AnMi3/buryak-pi-2020/docs/rev3/CPU_Shematic.pdf

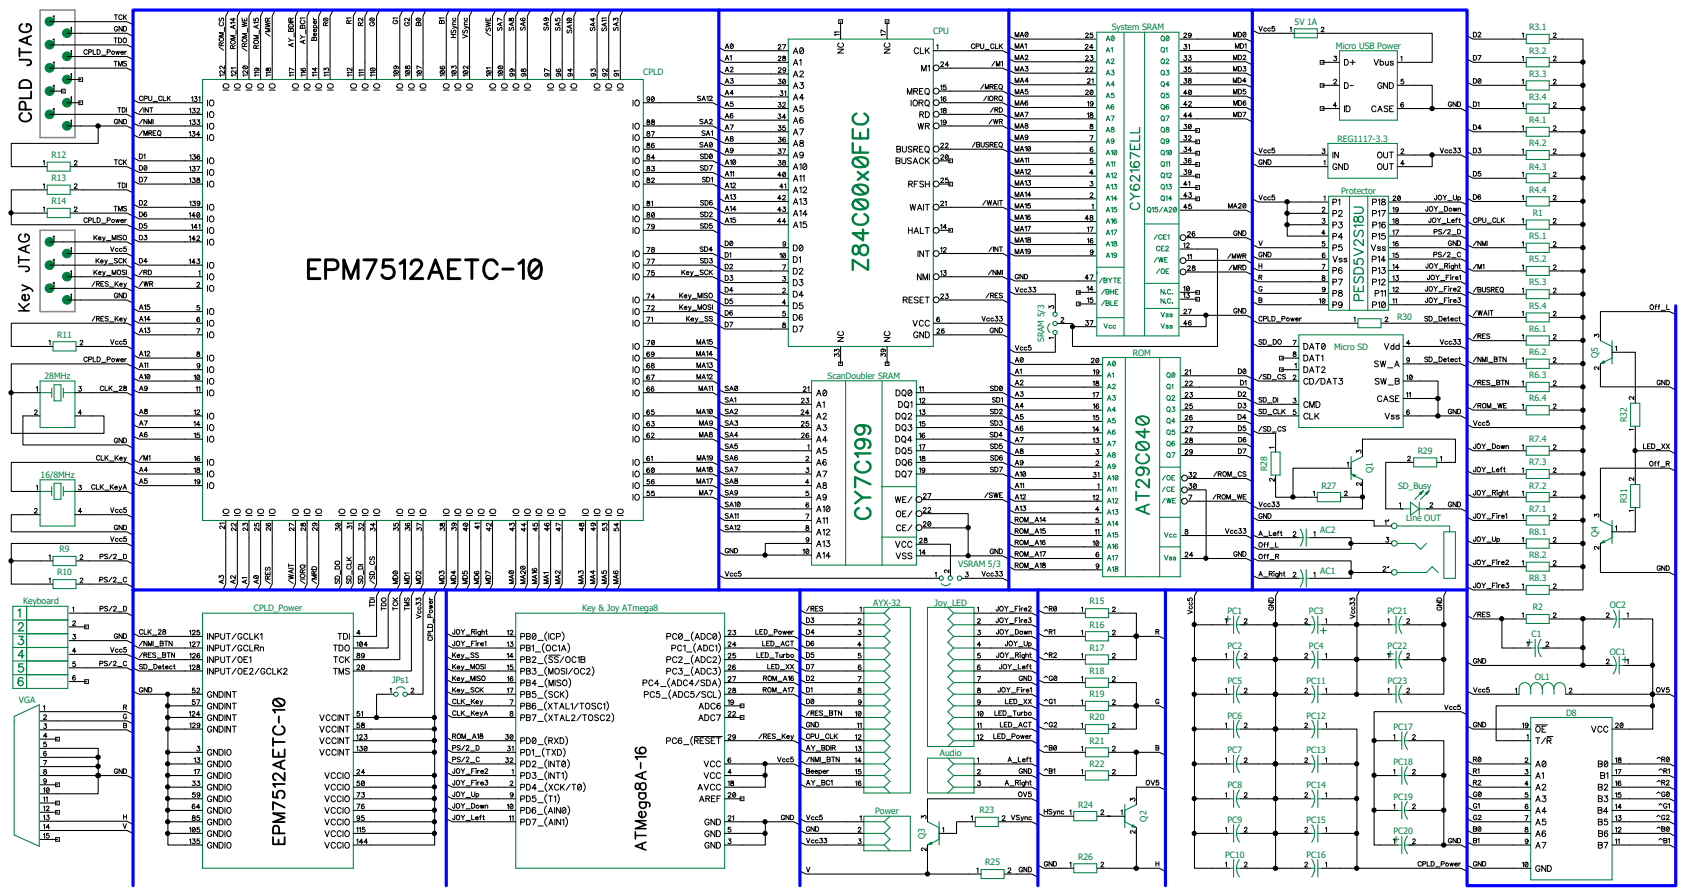
[picture p15: page 1]
