AnMi3/buryak-pi-2020/docs/rev3/Ext_Shematic.pdf

# PC8 PC9 PC10 PC11 R1

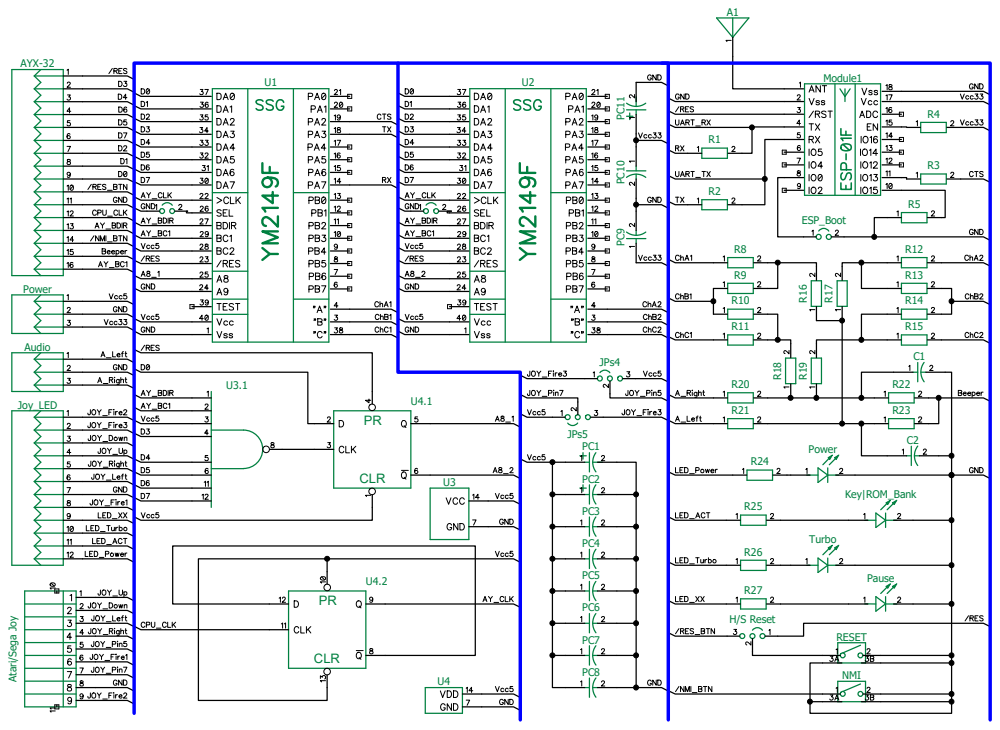
[picture p16: page 1]
