AnMi3/buryak-pi-2020/docs/rev1/buryak-pi-2020-cmp-bot-rev1.pdf

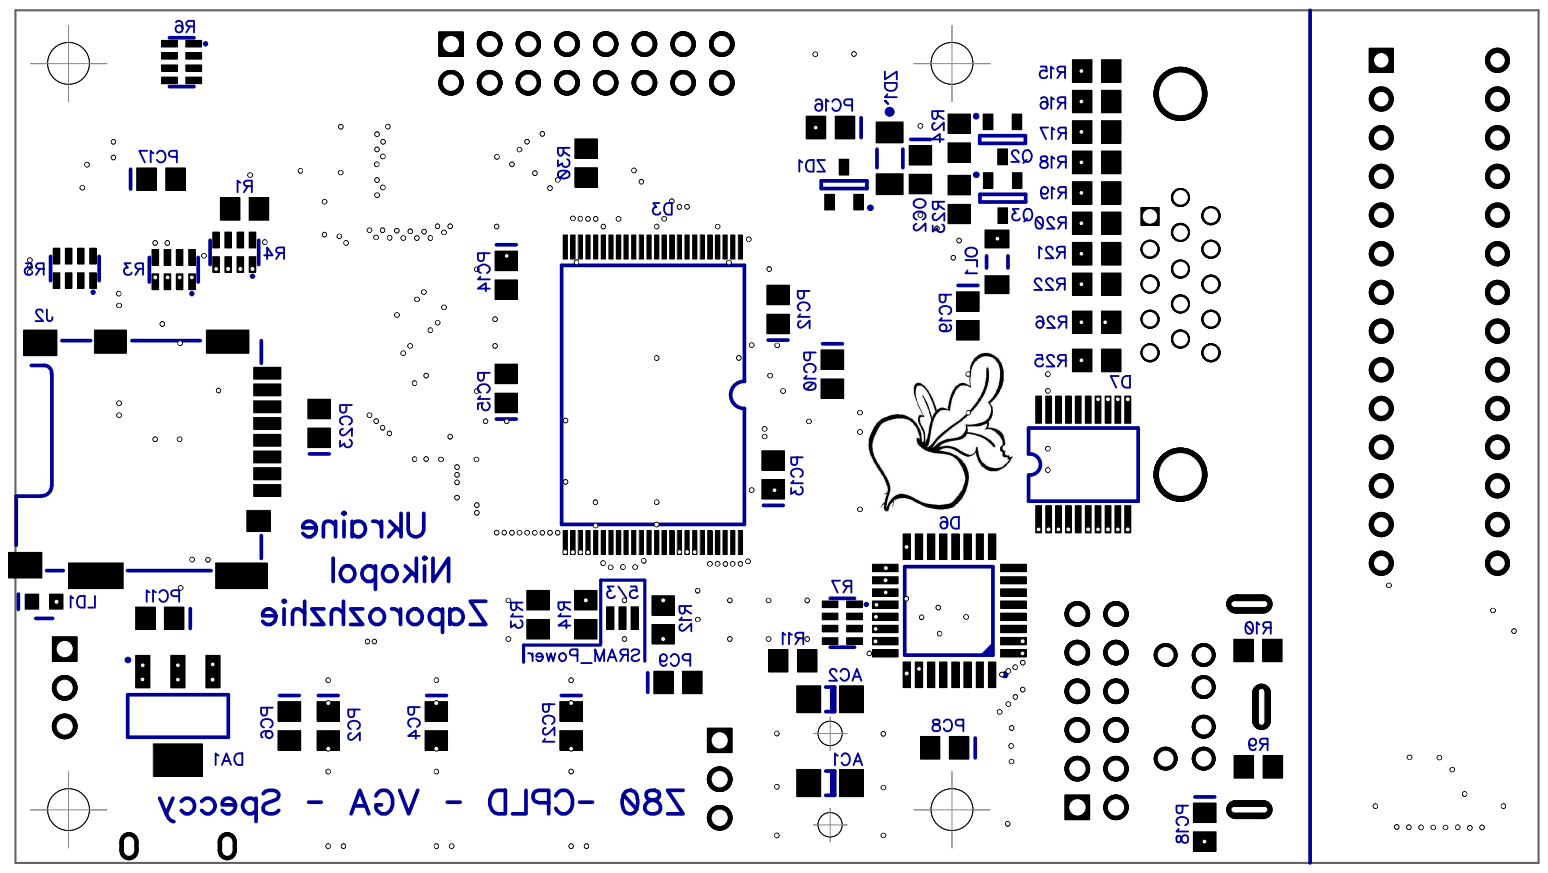
[picture p17: page 1]
