AnMi3/buryak-pi-2020/docs/rev1/buryak-pi-2020-cmp-ext-bot-rev1.pdf

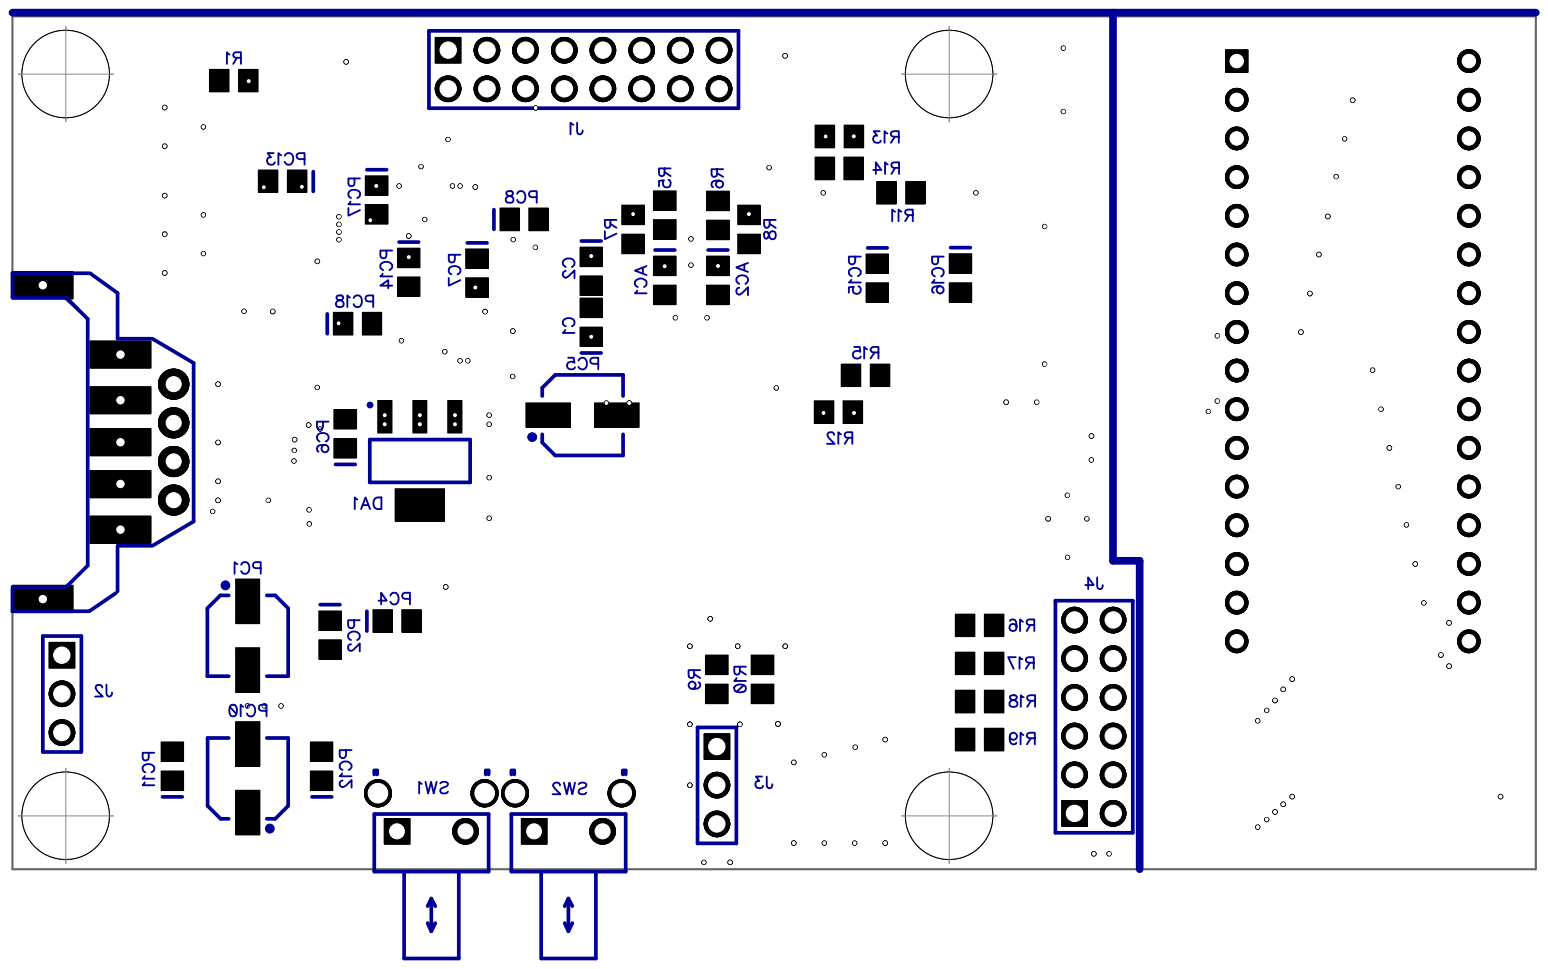
[picture p18: page 1]
