AnMi3/buryak-pi-2020/docs/rev1/buryak-pi-2020-cmp-ext-top-rev1.pdf

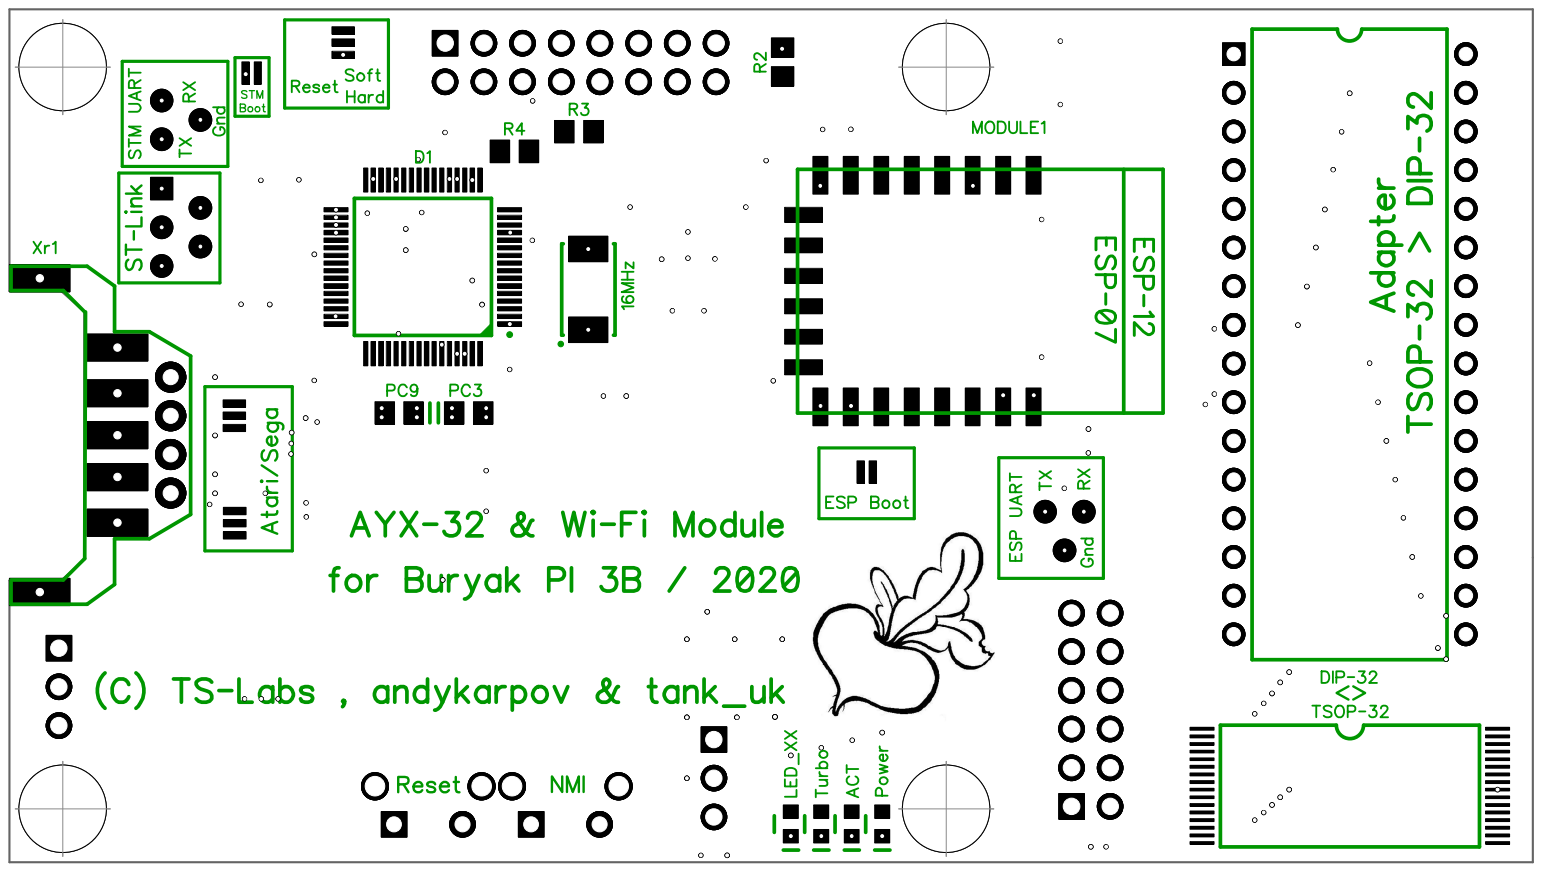
[picture p19: page 1]
