AnMi3/buryak-pi-2020/docs/rev1/buryak-pi-2020-cmp-top-rev1.pdf

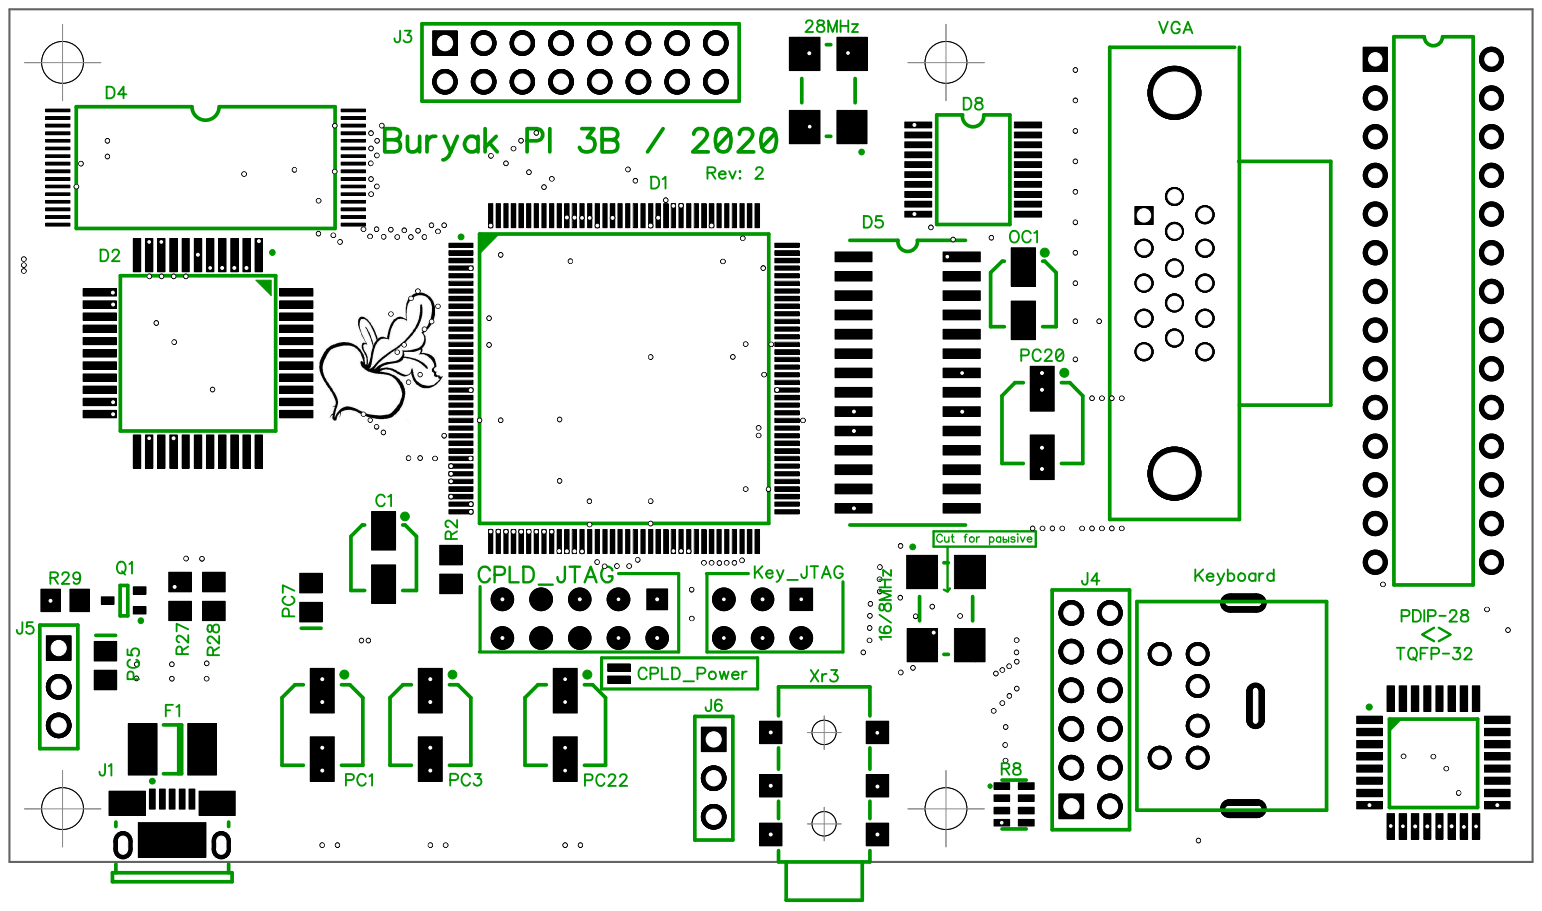
[picture p20: page 1]
