AnMi3/buryak-pi-2020/docs/rev2/buryak-pi-2020-sch-rev2.pdf

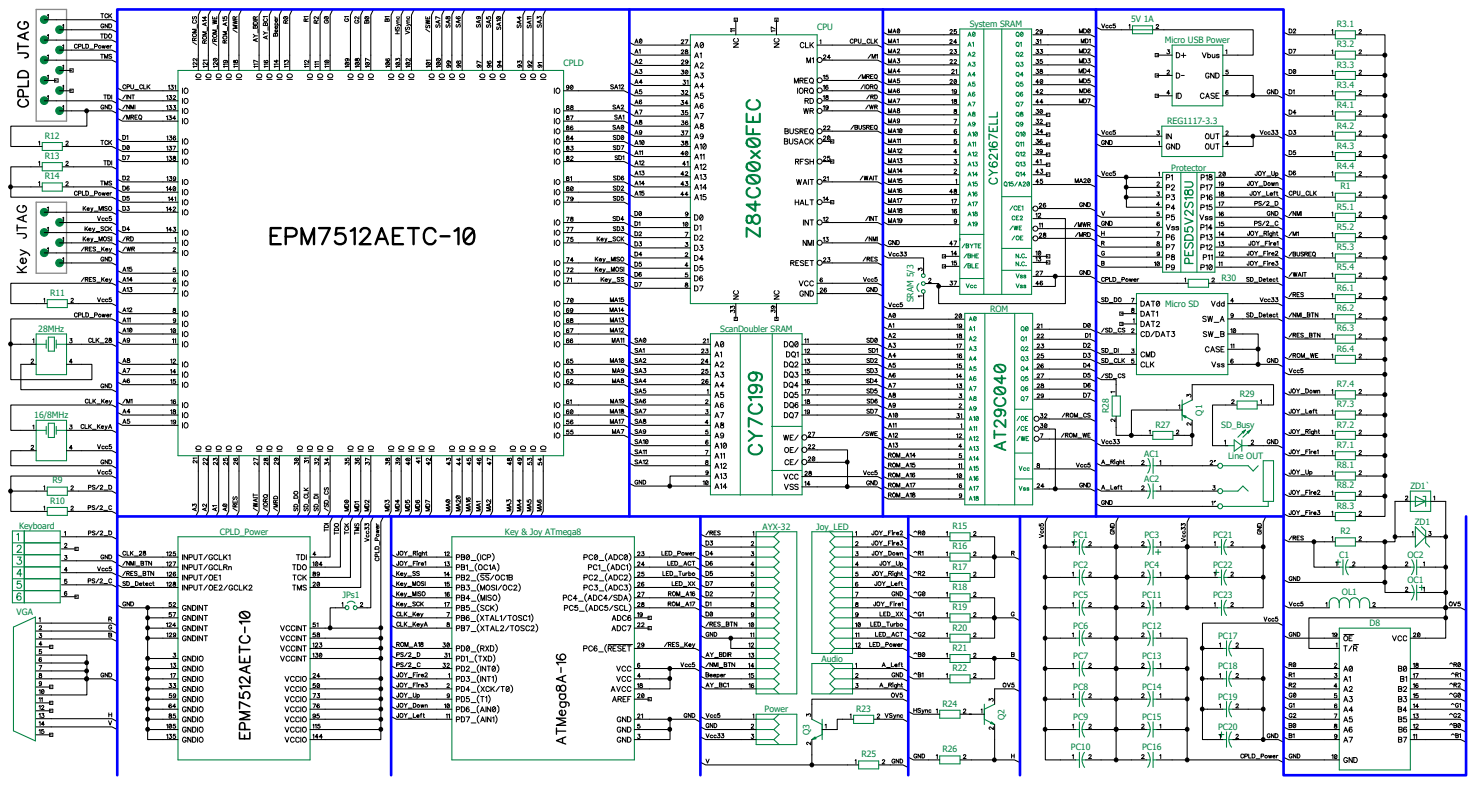
[picture p21: page 1]
