AnMi3/buryak-pi-2020/docs/rev1/buryak-pi-2020-sch-ext-rev1.pdf

# PC4 BOOT

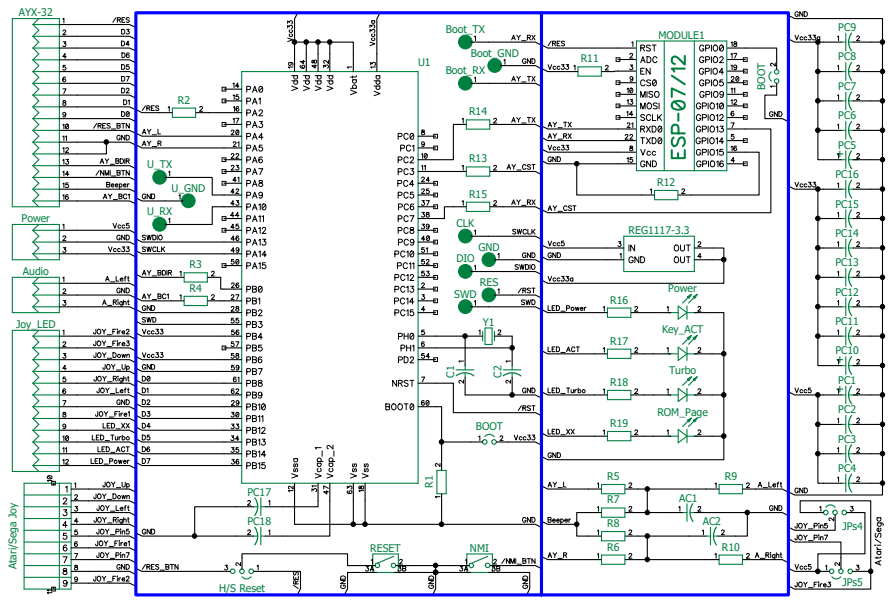
[picture p22: page 1]
