AnMi3/buryak-pi-2020/docs/rev1/buryak-pi-2020-sch-rev1.pdf

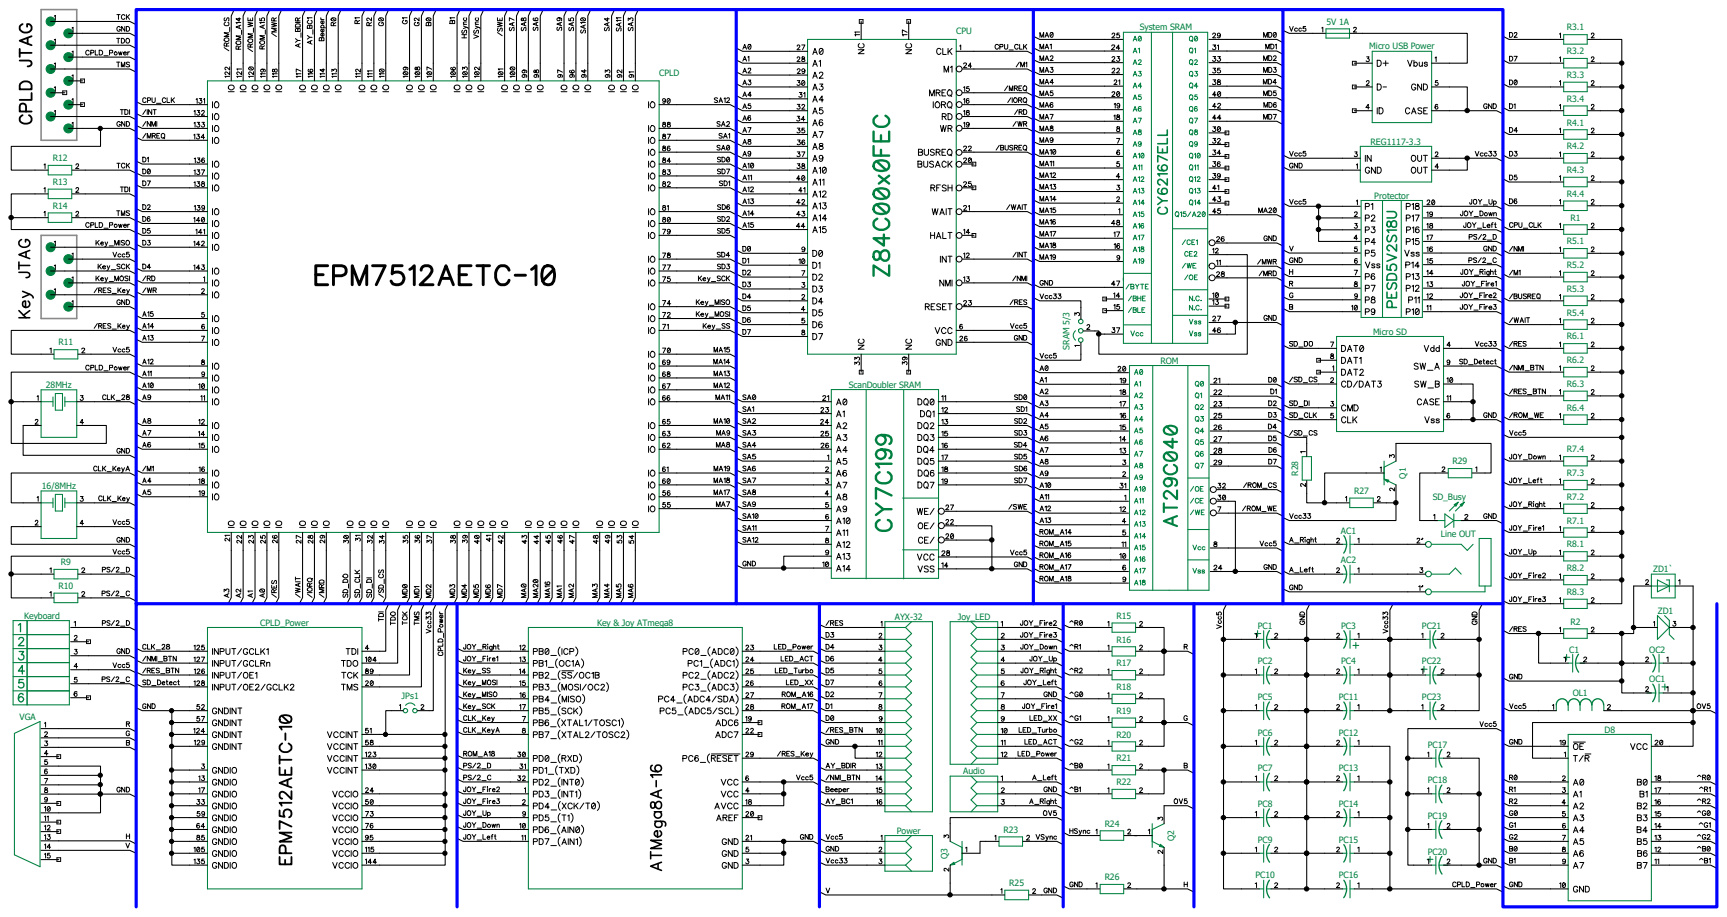
[picture p23: page 1]
