AnMi3/buryak-pi-2020/(commit log)

2020-06-30 Added documentation for the CPU board of the buryak-pi 2020
2020-07-24 Full shematic & bom
2020-07-25 Add files via upload
    Исправлена схема, исправлена плата, добавлена инструкция по прошивке и герберы для производства
2020-07-25 Issue #2: remapped keyboard F keys
    [avr_kbd.ino]
2020-07-25 LED_XX also on while in wait state
2020-07-25 Added blinked led on wait state
2020-07-25 Фотографии буряка
2020-07-25 добавлены фото в README
2020-07-29 Fixed bug with sticky keys
    [avr_kbd.ino]
2020-07-30 Дополнены мануалы
2020-08-11 Обновленная схема верхушки
2020-08-11 Добавлен бинарь прошивки AYX32
2020-08-11 Обновлен howto
2020-08-11 Добавлена передача состояния ромбанка при старте, добавлено мигание светодиодом активности в режиме паузы
2020-08-12 Update README.md
    Добавлены фичи
2020-08-15 fixed pong joystick controls
    [cpld_kbd.vhd]
2020-08-15 Added pause mode by PrintScreen button
2020-08-16 fixed new paddle size top vpos
    [tennis.v]
2020-08-16 reverted timex video modes
    [firmware_top.vhd]
2020-08-17 revert ACT blink on wait
    [avr_kbd.ino]
2020-10-23 Add files via upload
    Прошивка Wild Sound II с портом IOA для работы WiFi
